dylanfalzone/BARK_system_2023/README.md

# BARK_system_2023
Academic project for University of Florida Junior Design, including PCB schematics, design reviews, python code, and some 3D models.
