dylanfalzone/BARK_system_2023/control.stl

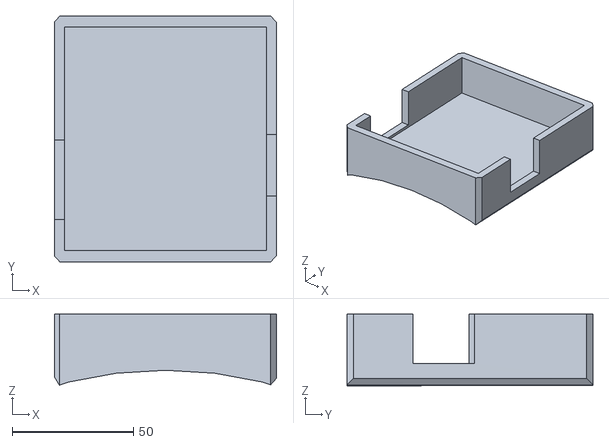
[picture p13: CAD file, 2024-05-21]
control.stl
91.4 x 101.3 x 29.4
