dylanfalzone/BARK_system_2023/(list of files, drawings)

Other design files:
PCB1.PcbDoc
Sheet2.SchDoc
