dylanfalzone/BARK_system_2023/temp characterization.xlsx

Temp | Voltage
-40 | 0.1
25 | 0.75
50 | 1
